TimMJN/Arduino-Clock-Divider/images/arduino_clock_divider_render_front.png

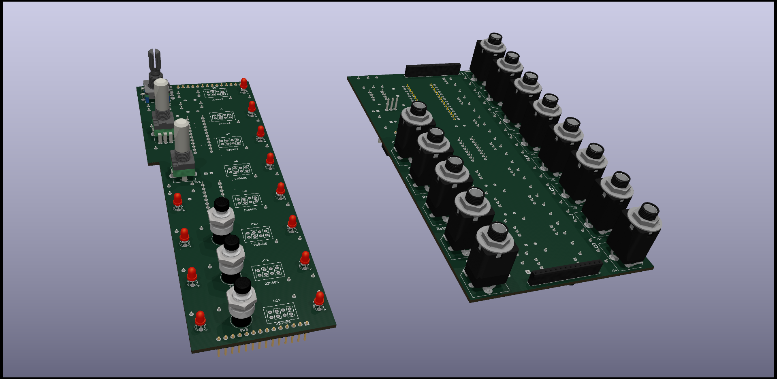
images/arduino_clock_divider_render_front.png
