TimMJN/Arduino-Clock-Divider/images/arduino_clock_divider_render_back.png

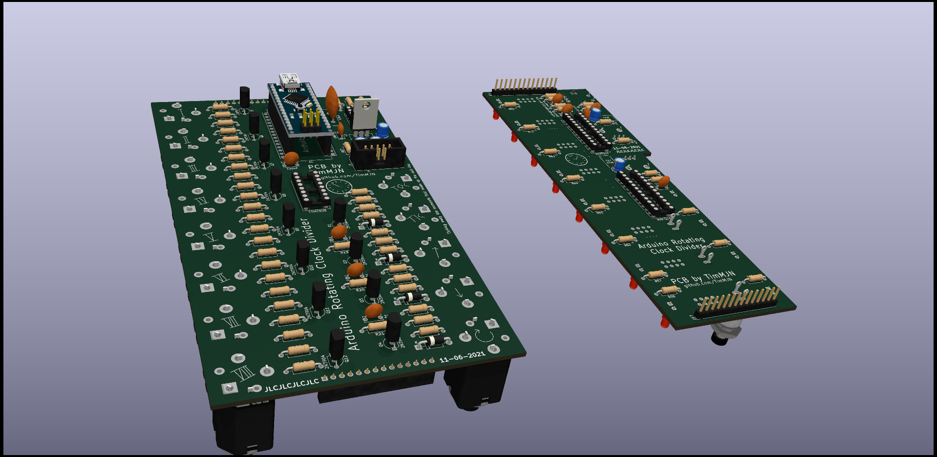
images/arduino_clock_divider_render_back.png
