TimMJN/Arduino-Clock-Divider/datasheets/2354BS.png

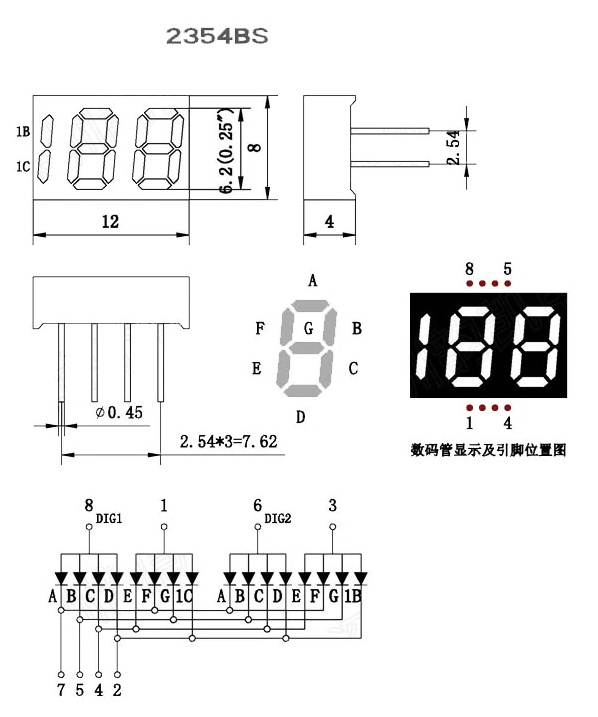
datasheets/2354BS.png
