TimMJN/Arduino-Clock-Divider/PCB/arduino_clock_divider-PCB_back.png

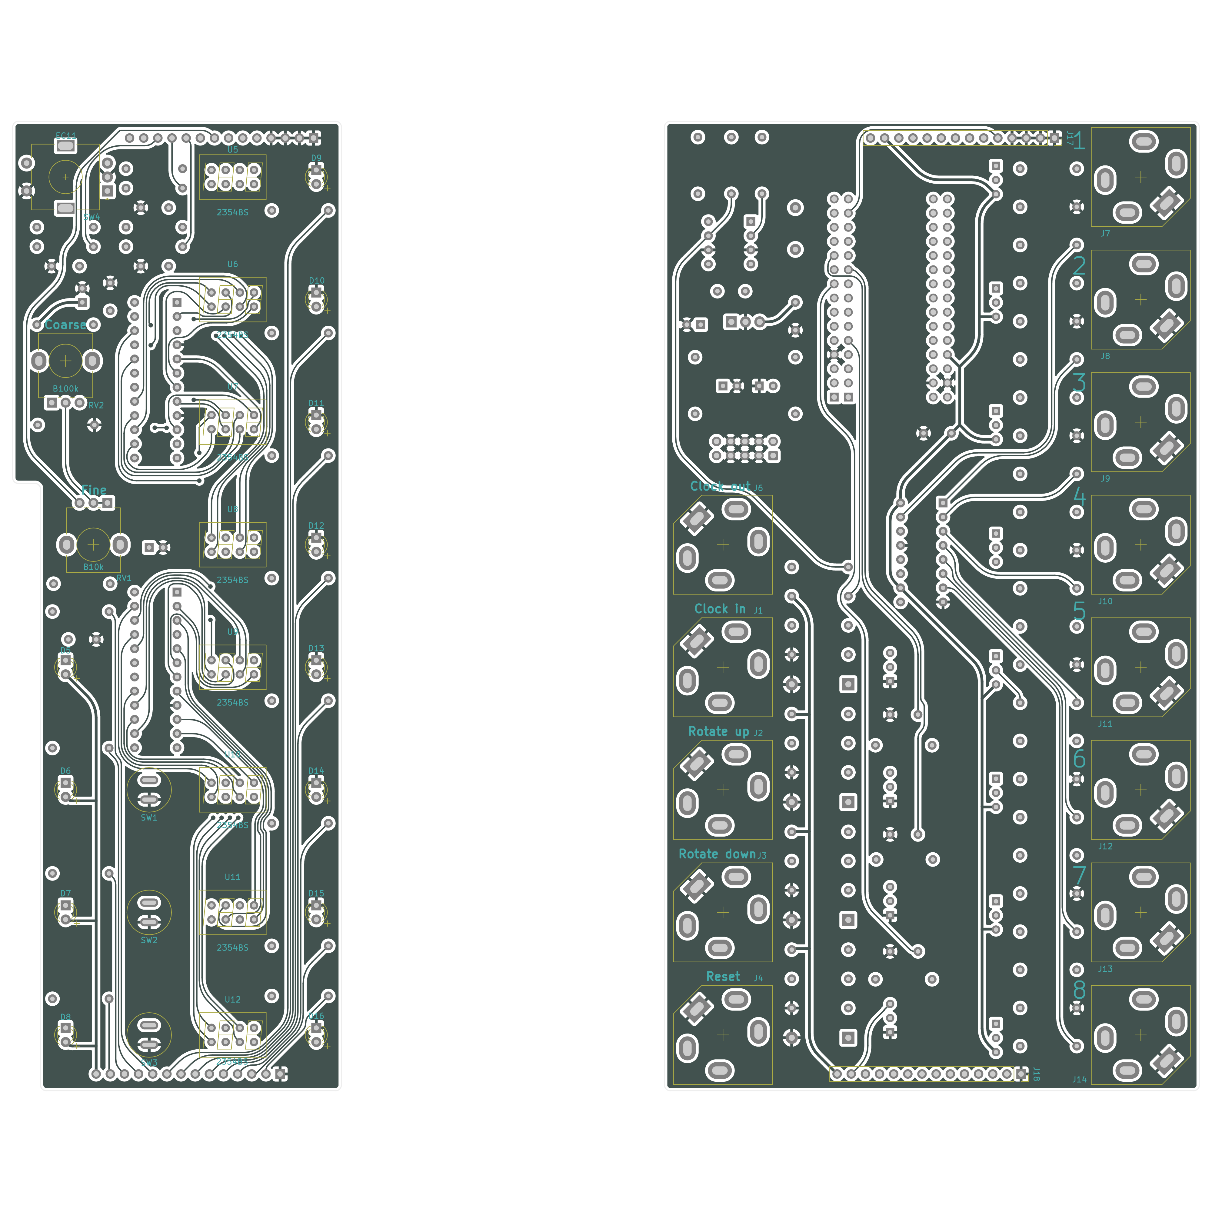
PCB/arduino_clock_divider-PCB_back.png
