TimMJN/Arduino-Clock-Divider/PCB/arduino_clock_divider-PCB_front.png

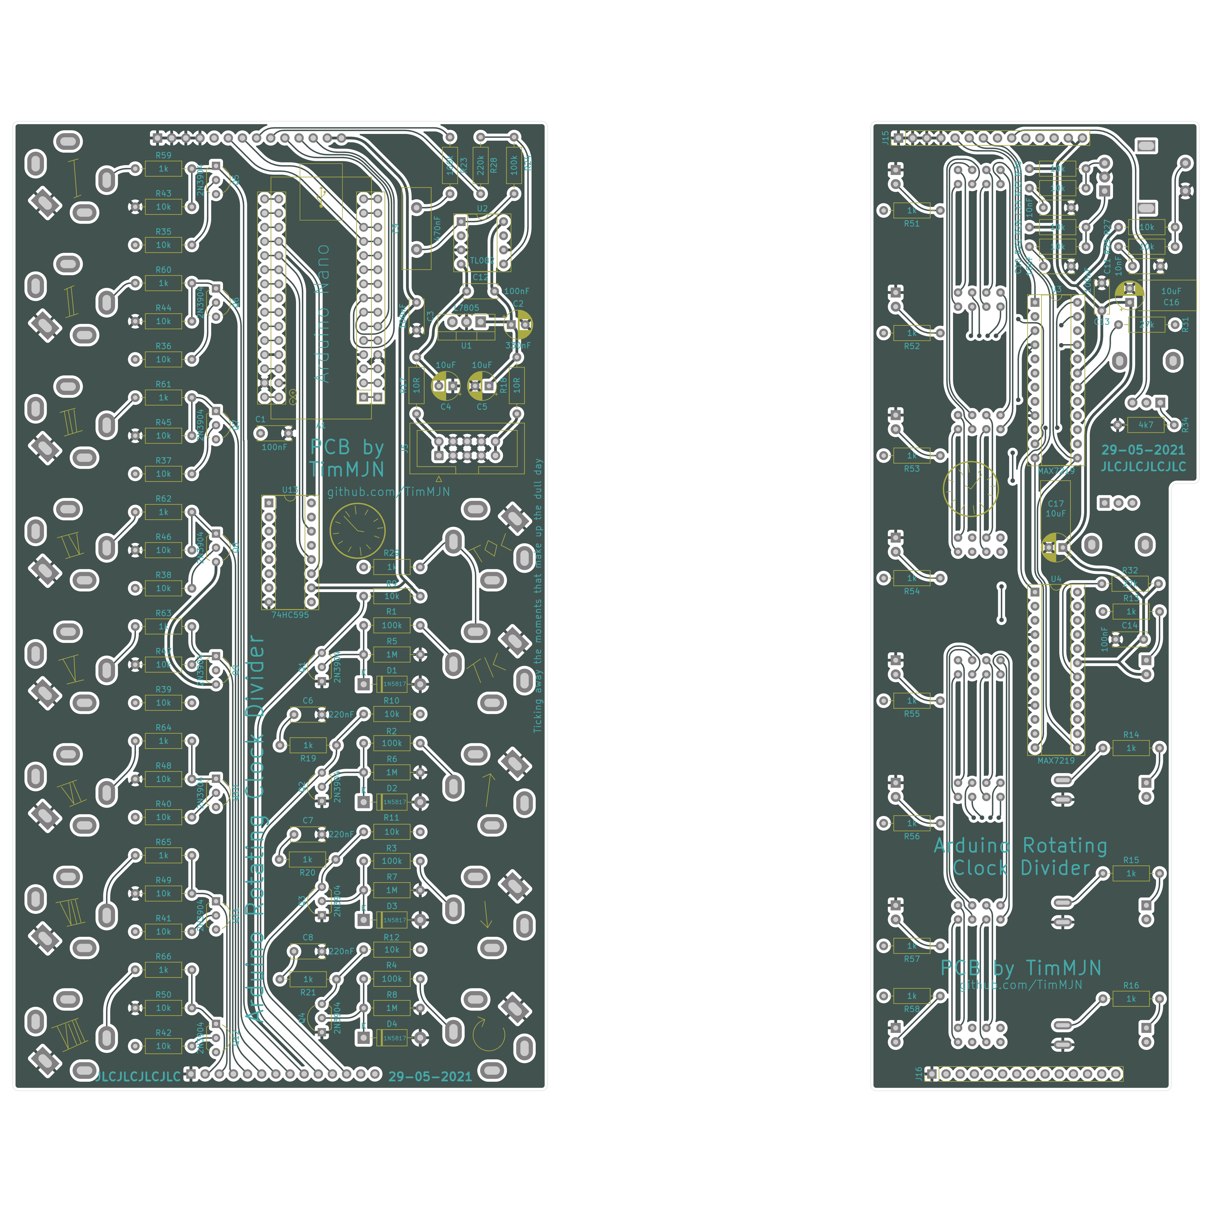
PCB/arduino_clock_divider-PCB_front.png
