TimMJN/Arduino-Clock-Divider/schematic+BOM/arduino_clock_divider_BOM.pdf

Arduino Clock Divider | Rev: v1.21
TimMJN | 29-05-2022

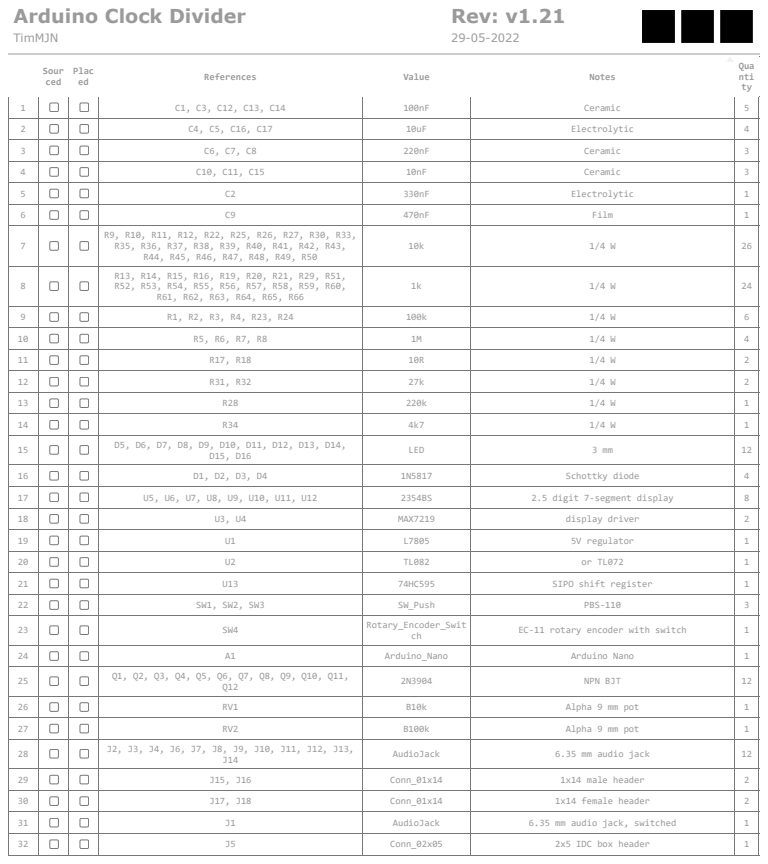
[picture p6: page 1]

Sour ced | Plac ed | References | Value | Notes | Qua nti ty

1 | | | C1, C3, C12, C13, C14 | 100nF | Ceramic | 5

2 | | | C4, C5, C16, C17 | 10uF | Electrolytic | 4

3 | | | C6, C7, C8 | 220nF | Ceramic | 3

4 | | | C10, C11, C15 | 10nF | Ceramic | 3

5 | | | C2 | 330nF | Electrolytic | 1

6 | | | C9 | 470nF | Film | 1
7 | | | R9, R10, R11, R12, R22, R25, R26, R27, R30, R33, R35, R36, R37, R38, R39, R40, R41, R42, R43, R44, R45, R46, R47, R48, R49, R50 | 10k | 1/4 W | 26

14 | | | R34 | 4k7 | 1/4 W | 1
15 | | | D5, D6, D7, D8, D9, D10, D11, D12, D13, D14, D15, D16 | LED | 3 mm | 12

16 | | | D1, D2, D3, D4 | 1N5817 | Schottky diode | 4

17 | | | U5, U6, U7, U8, U9, U10, U11, U12 | 2354BS | 2.5 digit 7-segment display | 8

18 | | | U3, U4 | MAX7219 | display driver | 2

19 | | | U1 | L7805 | 5V regulator | 1

21 | | | U13 | 74HC595 | SIPO shift register | 1

22 | | | SW1, SW2, SW3 | SW_Push | PBS-110 | 3
23 | | | SW4 | Rotary_Encoder_Swit ch | EC-11 rotary encoder with switch | 1

24 | | | A1 | Arduino_Nano | Arduino Nano | 1
25 | | | Q1, Q2, Q3, Q4, Q5, Q6, Q7, Q8, Q9, Q10, Q11, Q12 | 2N3904 | NPN BJT | 12

26 | | | RV1 | B10k | Alpha 9 mm pot | 1

27 | | | RV2 | B100k | Alpha 9 mm pot | 1
28 | | | J2, J3, J4, J6, J7, J8, J9, J10, J11, J12, J13, J14 | AudioJack | 6.35 mm audio jack | 12

29 | | | J15, J16 | Conn_01x14 | 1x14 male header | 2

30 | | | J17, J18 | Conn_01x14 | 1x14 female header | 2

31 | | | J1 | AudioJack | 6.35 mm audio jack, switched | 1

32 | | | J5 | Conn_02x05 | 2x5 IDC box header | 1
