TimMJN/Arduino-Clock-Divider/PCB/arduino_clock_divider-Panel_drill_guide.pdf

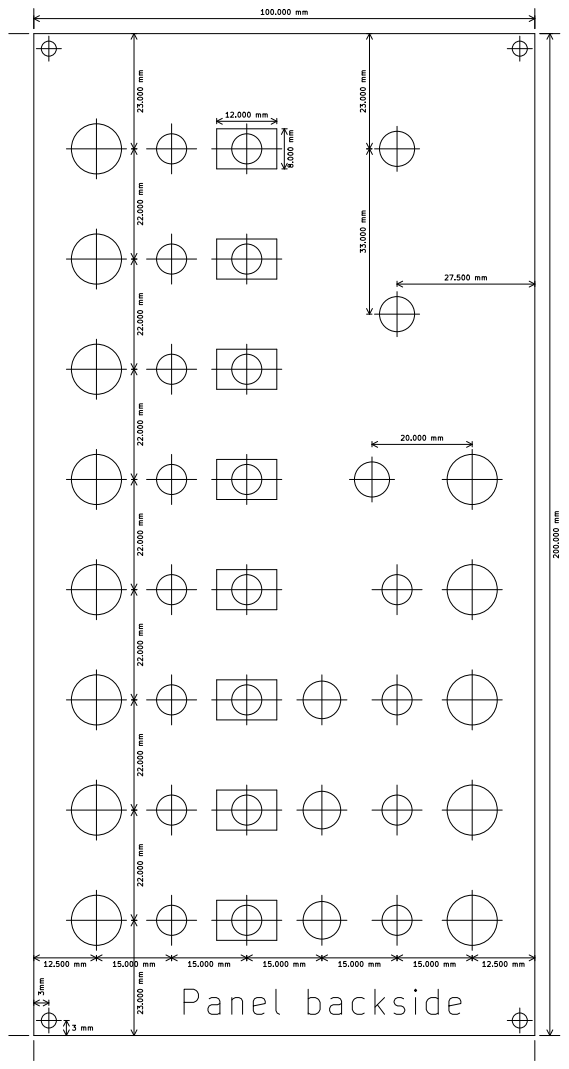
[picture p7: page 1]

Id: 1/1 Title: Arduino Clock Divider
