TimMJN/Arduino-Clock-Divider/schematic+BOM/arduino_clock_divider.pdf

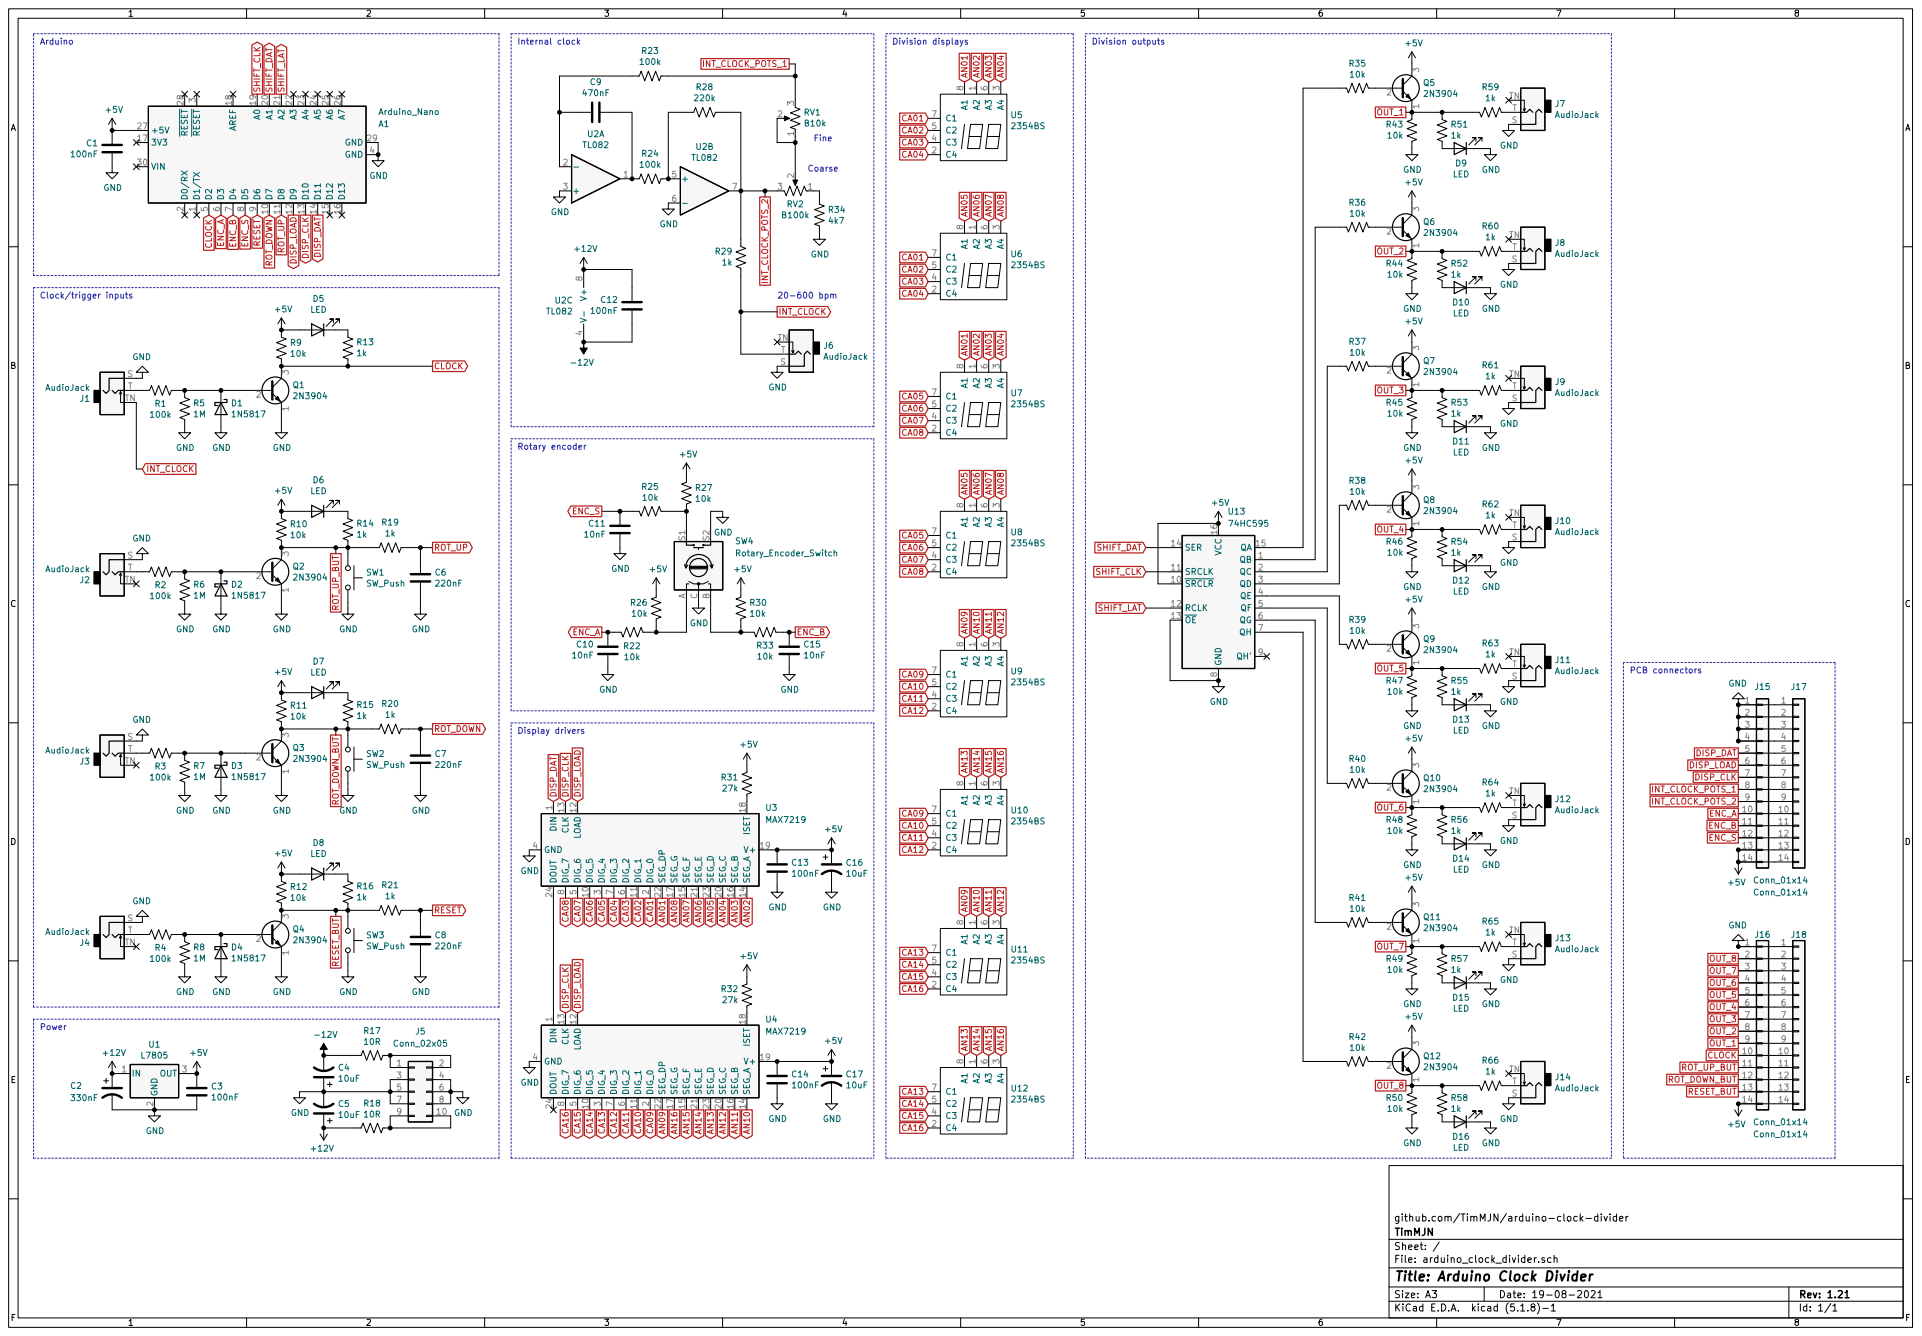
[picture p8: page 1]

Coarse Fine Rotary encoder Power

R25 | 10k C15 | 2354BS DIN

PCB connectors Display drivers

github.com/TimMJN/arduino-clock-divider GND

File: arduino_clock_divider.sch Sheet: / TimMJN

Id: 1/1 Title: Arduino Clock Divider
