TimMJN/Arduino-Clock-Divider/(commit log)

2021-03-09 schematic update
2021-04-24 added PCB
2021-05-15 add BOM
2021-05-15 added ledcontrol library
2021-05-15 PCB update
2021-05-15 update to new schematic
2021-06-05 update BOM
2021-06-08 moved pcb files
2021-06-19 moved LedControl
2021-08-19 added interactive BOM
2021-08-19 added PCB connectors to schematic
2021-11-28 added dimensions to drill guide
2022-05-29 add pcb images
